avbrahm/PWR-MGR-PCB/README.md

# PWR-MGR-PCB
Power Management PCB with USB-C.
Designed to handle single cell lipo charging with direct power path. Outputs regulated 3.3V for microcontrollers and ESD protected USB data lines. 

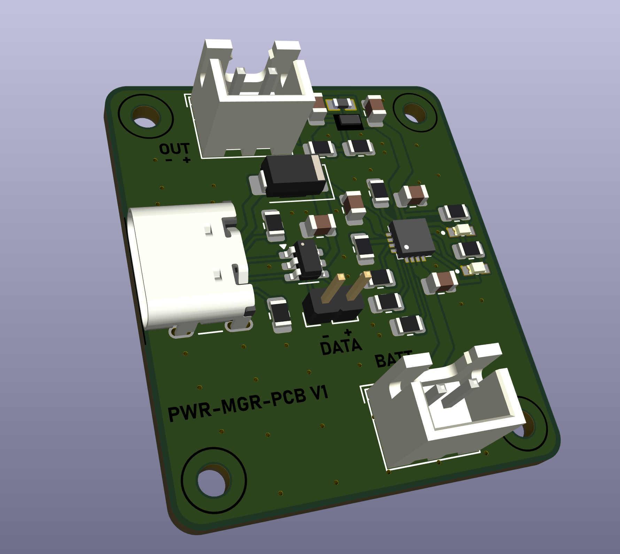
[picture p1: board.png]
Board
