avbrahm/PWR-MGR-PCB/(list of files, drawings)

Other design files:
PWR-MGR-PCB/freerouting.dsn
PWR-MGR-PCB/temp-freerouting.dsn
