avbrahm/PWR-MGR-PCB/PWR-MGR-PCB/PWR-MGR-PCB.kicad_pcb

## KiCad design PWR-MGR-PCB/PWR-MGR-PCB.kicad_pcb (2026-10-29)

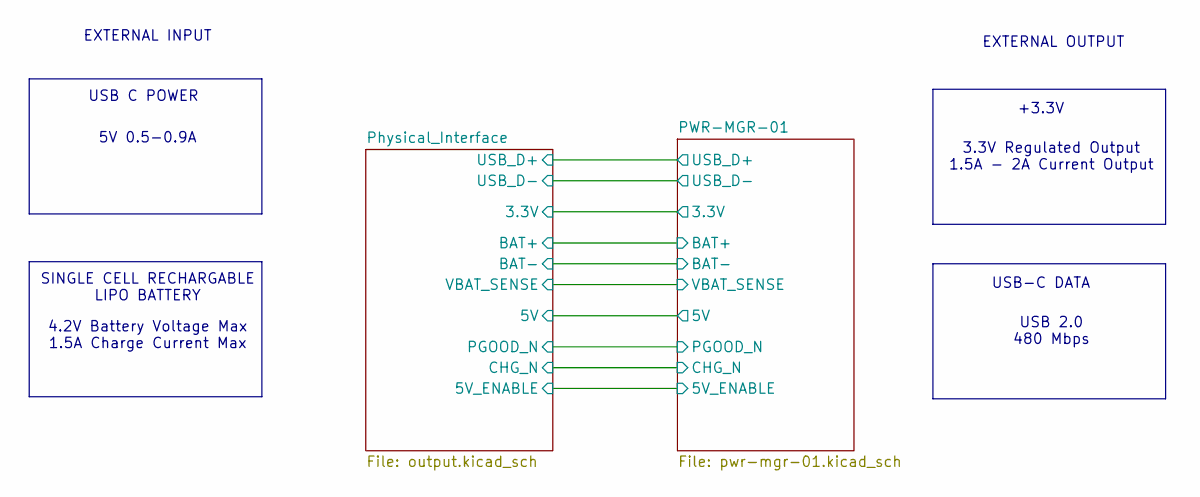
[picture p2: schematic PWR-MGR-PCB.kicad_sch, PWR-MGR-PCB-01]

Notes on the sheet:
SINGLE CELL RECHARGABLE LIPO BATTERY
USB 2.0 480 Mbps
3.3V Regulated Output 1.5A - 2A Current Output
5V 0.5-0.9A
EXTERNAL INPUT
4.2V Battery Voltage Max 1.5A Charge Current Max
USB-C DATA
EXTERNAL OUTPUT
USB C POWER
+3.3V

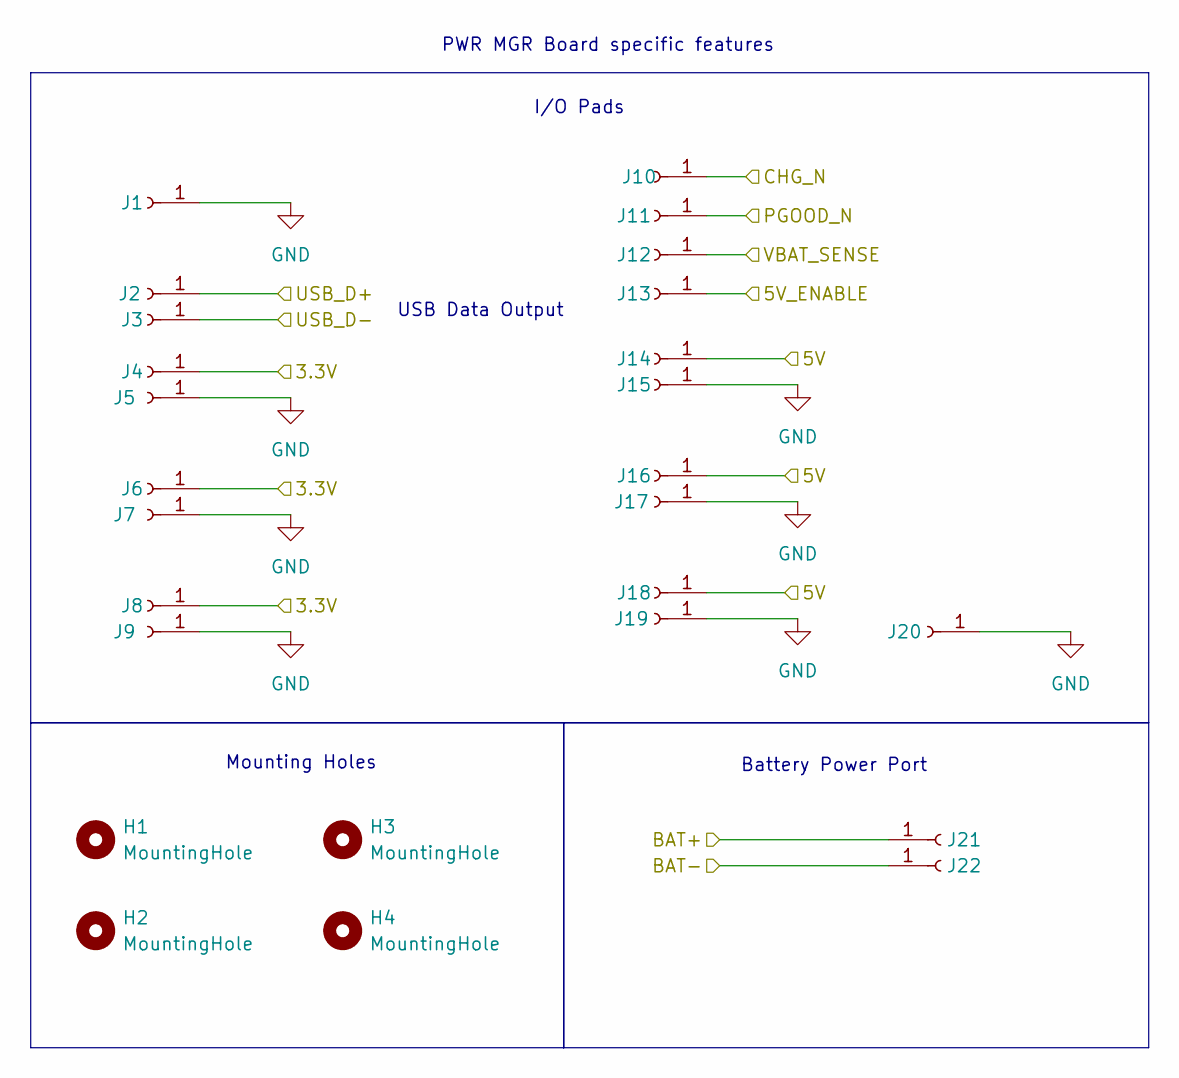
[picture p3: schematic output.kicad_sch]

Parts:
H1, H2, H3, H4: MountingHole; MountingHole_2.1mm
J1, J2, J3, J4, J5, J6, J7, J8, J9, J10, J11, J12, J13, J14, J15, J16, J17, J18, J19, J20, J21, J22: Conn_01x01_Socket; Drilled_Solder_Pad_0.6mm_3x1mm

Connections:
+3.3V: J4.1 (Pin_1_1), J6.1 (Pin_1_1), J8.1 (Pin_1_1); also elsewhere on the board
+5V: J14.1 (Pin_1_1), J16.1 (Pin_1_1), J18.1 (Pin_1_1); also elsewhere on the board
/PWR-MGR-01/5V_ENABLE: J13.1 (Pin_1_1); also elsewhere on the board
/PWR-MGR-01/BAT+: J21.1 (Pin_1_1); also elsewhere on the board
/PWR-MGR-01/CHG_N: J10.1 (Pin_1_1); also elsewhere on the board
/PWR-MGR-01/PGOOD_N: J11.1 (Pin_1_1); also elsewhere on the board
/PWR-MGR-01/USB_D+: J2.1 (Pin_1_1); also elsewhere on the board
/PWR-MGR-01/USB_D-: J3.1 (Pin_1_1); also elsewhere on the board
/PWR-MGR-01/VBAT_SENSE: J12.1 (Pin_1_1); also elsewhere on the board
GND: J1.1 (Pin_1_1), J5.1 (Pin_1_1), J7.1 (Pin_1_1), J9.1 (Pin_1_1), J15.1 (Pin_1_1), J17.1 (Pin_1_1), J19.1 (Pin_1_1), J20.1 (Pin_1_1), J22.1 (Pin_1_1); also elsewhere on the board

Notes on the sheet:
I/O Pads
Mounting Holes
Battery Power Port
PWR MGR Board specific features
USB Data Output

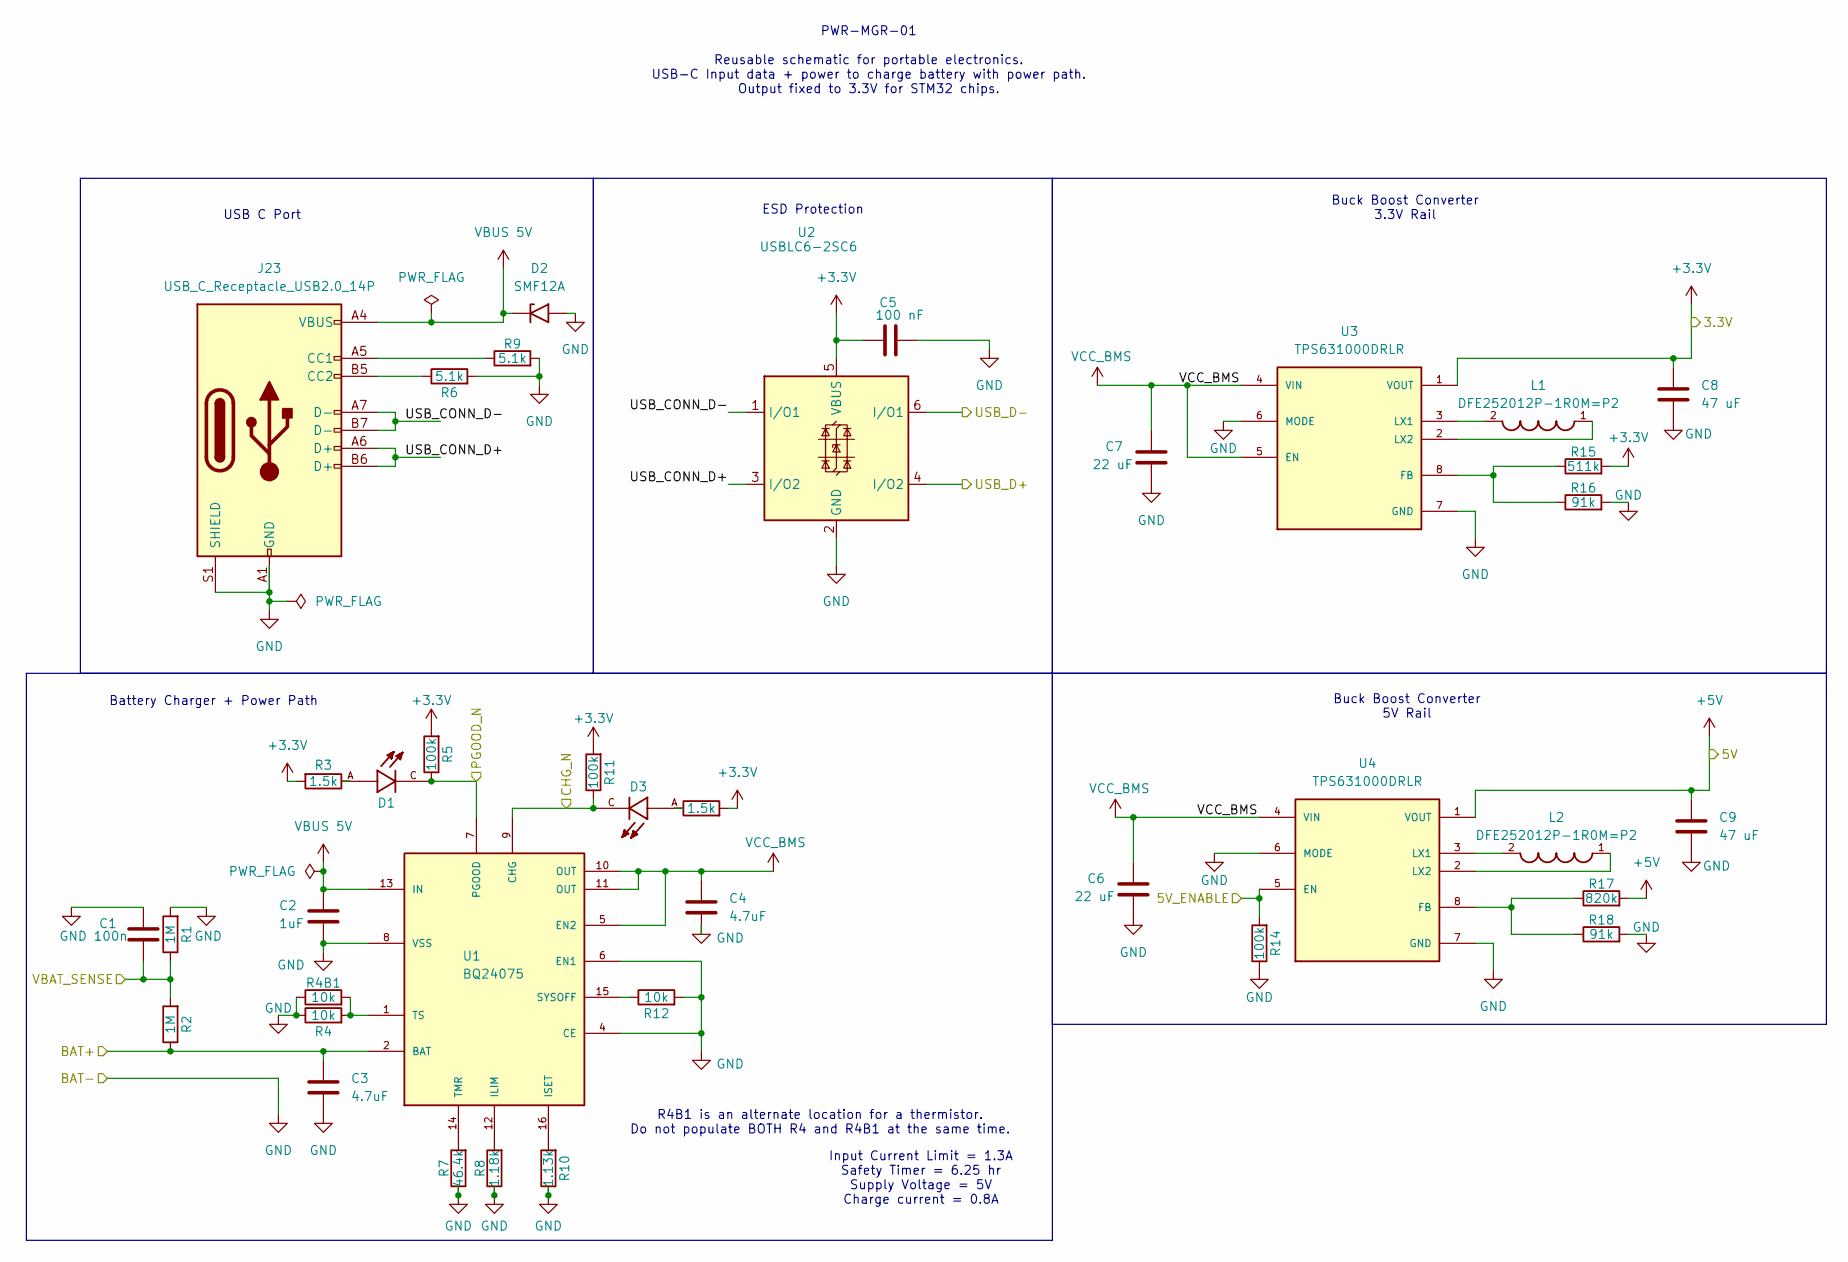
[picture p4: schematic pwr-mgr-01.kicad_sch]

Parts:
C1: 100n; C_0805_2012Metric; Manufacturer Part Number KAF21KR71H105JU
C2: 1uF; C_0805_2012Metric; Manufacturer Part Number KAF21KR71H105JU
C3, C4: 4.7uF; C_0805_2012Metric; Manufacturer Part Number CL21B475KBB6PNE
C5: 100 nF; C_0805_2012Metric; Manufacturer Part Number 08056D107MAT2A
C6, C7: 22 uF; C_0805_2012Metric; Manufacturer Part Number KAM21AT70J226MU
C8, C9: 47 uF; C_0805_2012Metric; Manufacturer Part Number CC0805MKX5R6BB476
D1, D3: SML-D12U1WT86; LED_SML-D12U1WT86; PARTREV 007
D2: SMF12A; D_SMF
J23: USB_C_Receptacle_USB2.0_14P; USB_C_Receptacle_GCT_USB4105-xx-A_16P_TopMnt_Horizontal; Manufacturer Part Number USB4105-GF-A
L1, L2: DFE252012P-1R0M=P2; INDC2520X120N
R1, R2: 1M; R_0805_2012Metric; Manufacturer Part Number MCU0805MD1002BP500
R3, R13: 1.5k; R_0805_2012Metric; Manufacturer Part Number RT73F2A1K5BTD
R4, R4B1: 10k; R_0805_2012Metric_Pad1.20x1.40mm_HandSolder; Manufacturer Part Number MCU0805MD1002BP500
R5, R11, R14: 100k; R_0805_2012Metric; Manufacturer Part Number MCU0805MD1002BP500
R6, R9: 5.1k; R_0805_2012Metric; Manufacturer Part Number ERA-6ARB512V
R7: 46.4k; R_0805_2012Metric; Manufacturer Part Number ERA-6AED4642V
R8: 1.18k; R_0805_2012Metric; Manufacturer Part Number ERJ-U06D1181V
R10: 1.13k; R_0805_2012Metric; Manufacturer Part Number PAT0805E1131BST1
R12: 10k; R_0805_2012Metric; Manufacturer Part Number MCU0805MD1002BP500
R15: 511k; R_0805_2012Metric; Manufacturer Part Number CR0805-FX-5113ELF
R16, R18: 91k; R_0805_2012Metric; Manufacturer Part Number ERA-6ARB913V
R17: 820k; R_0805_2012Metric; Manufacturer Part Number CR0805-FX-5113ELF
U1: BQ24075; QFN16; Manufacturer Part Number BQ24075RGTR
U2: USBLC6-2SC6; SOT-23-6; Manufacturer Part Number USBLC6-2SC6
U3, U4: TPS631000DRLR; SOT50P160X60-8N; PARTREV B

Connections:
+3.3V: C5.1, C8.1, R3.2, R5.2, R11.2, R13.2, R15.2, U2.5 (VBUS), U3.1 (VOUT); also elsewhere on the board
+5V: C9.1, R17.2, U4.1 (VOUT); also elsewhere on the board
/PWR-MGR-01/5V_ENABLE: R14.2, U4.5 (EN); also elsewhere on the board
/PWR-MGR-01/BAT+: C3.1, R2.1, U1.2 (BAT), U1.3 (BAT); also elsewhere on the board
/PWR-MGR-01/CHG_N: D3.C, R11.1, U1.9 (CHG); also elsewhere on the board
/PWR-MGR-01/PGOOD_N: D1.C, R5.1, U1.7 (PGOOD); also elsewhere on the board
/PWR-MGR-01/USB_CONN_D+: J23.A6 (D+), J23.B6 (D+), U2.3 (I/O2)
/PWR-MGR-01/USB_CONN_D-: J23.A7 (D-), J23.B7 (D-), U2.1 (I/O1)
/PWR-MGR-01/USB_D+: U2.4 (I/O2); also elsewhere on the board
/PWR-MGR-01/USB_D-: U2.6 (I/O1); also elsewhere on the board
/PWR-MGR-01/VBAT_SENSE: C1.2, R1.1, R2.2; also elsewhere on the board
GND: C1.1, C2.2, C3.2, C4.2, C5.2, C6.2, C7.2, C8.2, C9.2, D2.2 (A2), J23.A1 (GND), J23.A12 (GND), J23.B1 (GND), J23.B12 (GND), J23.S1 (SHIELD), R1.2, R4.1, R4B1.1, R6.2, R7.1, R8.1, R9.2, R10.1, R12.2, R14.1, R16.2, R18.2, U1.4 (CE), U1.6 (EN1), U1.8 (VSS), U1.TH (VSS), U2.2 (GND), U3.6 (MODE), U3.7 (GND), U4.6 (MODE), U4.7 (GND); also elsewhere on the board
unnamed: D1.A, R3.1
unnamed: D3.A, R13.1
unnamed: J23.A5 (CC1), R9.1
unnamed: J23.B5 (CC2), R6.1
unnamed: R8.2, U1.12 (ILIM)
unnamed: R10.2, U1.16 (ISET)
unnamed: R12.1, U1.15 (SYSOFF)
unnamed: R7.2, U1.14 (TMR)
unnamed: R4.2, R4B1.2, U1.1 (TS)
unnamed: R15.1, R16.1, U3.8 (FB)
unnamed: L1.2, U3.3 (LX1)
unnamed: L1.1, U3.2 (LX2)
unnamed: R17.1, R18.1, U4.8 (FB)
unnamed: L2.2, U4.3 (LX1)
unnamed: L2.1, U4.2 (LX2)
VBUS 5V: C2.1, D2.1 (A1), J23.A4 (VBUS), J23.A9 (VBUS), J23.B4 (VBUS), J23.B9 (VBUS), U1.13 (IN)
VCC_BMS: C4.1, C6.1, C7.1, U1.5 (EN2), U1.10 (OUT), U1.11 (OUT), U3.4 (VIN), U3.5 (EN), U4.4 (VIN)

Notes on the sheet:
Input Current Limit = 1.3A Safety Timer = 6.25 hr Supply Voltage = 5V Charge current = 0.8A
Battery Charger + Power Path
Buck Boost Converter 3.3V Rail
R4B1 is an alternate location for a thermistor. Do not populate BOTH R4 and R4B1 at the same time.
Buck Boost Converter 5V Rail
USB C Port
ESD Protection
PWR-MGR-01 Reusable schematic for portable electronics. USB-C Input data + power to charge battery with power path. Output fixed to 3.3V for STM32 chips.

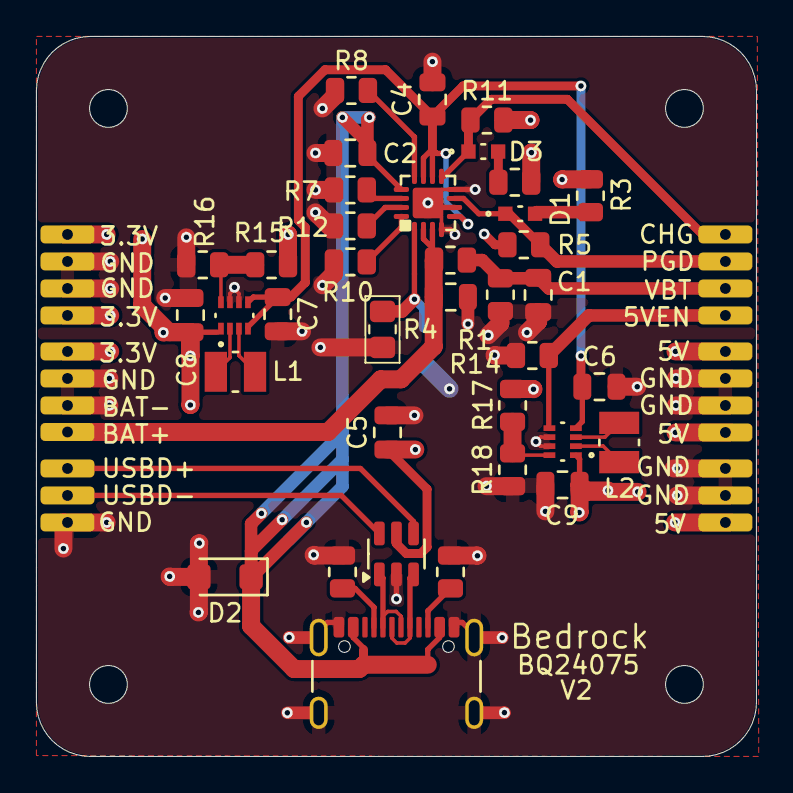
[picture p5: board PWR-MGR-PCB.kicad_pcb from above]

Board: 4 copper layers, 40.0 x 40.0 mm, 64 parts (1 on the bottom side), 29 nets.
