avbrahm/PWR-MGR-PCB/(commit log)

2025-09-09 Init Repo
    [PWR-MGR-PCB.kicad_pcb, PWR-MGR-PCB.kicad_sch]
2025-09-10 Add test ports
    [PWR-MGR-PCB.kicad_pcb, PWR-MGR-PCB.kicad_sch]
2025-09-10 Start layout
    [PWR-MGR-PCB.kicad_pcb]
2025-09-14 Layout PCB
    [PWR-MGR-PCB.kicad_pcb]
2025-09-14 Resize board
    [PWR-MGR-PCB.kicad_pcb]
2025-09-14 Fix board layout
    [freerouting.dsn]
2025-09-18 Layout board
    [PWR-MGR-PCB.kicad_pcb]
2025-09-19 Route board
    [PWR-MGR-PCB.kicad_pcb, freerouting.dsn]
2025-09-24 Reroute board
    [PWR-MGR-PCB.kicad_pcb, PWR-MGR-PCB.kicad_sch]
2025-09-30 Sync latest fixes
    [PWR-MGR-PCB.kicad_sch]
2025-09-30 Update diode component
    [PWR-MGR-PCB.kicad_pcb, PWR-MGR-PCB.kicad_sch]
2025-10-07 Begin placing board
    [PWR-MGR-PCB.kicad_pcb]
2025-10-07 Refine outline
    [PWR-MGR-PCB.kicad_pcb]
2025-10-07 Start placement
    [PWR-MGR-PCB.kicad_pcb]
2025-10-14 Start bq2407 zones
    [PWR-MGR-PCB.kicad_pcb]
2025-10-16 Add filled zones around battery charger
    [PWR-MGR-PCB.kicad_pcb]
2025-10-16 Add power LEDs, connect battery terminal
    [PWR-MGR-PCB.kicad_pcb]
2025-10-18 Replace LDO with buck boost converter
    [PWR-MGR-PCB.kicad_sch]
2025-10-18 Add inductor
    [PWR-MGR-PCB.kicad_sch]
2025-10-18 Configure buck boost converter
    [PWR-MGR-PCB.kicad_pcb, PWR-MGR-PCB.kicad_sch]
2025-10-22 Route buck boost converter, add ground plane
    [PWR-MGR-PCB.kicad_pcb, PWR-MGR-PCB.kicad_sch]
2025-10-22 Add USB lines, add mount holes, add power port
    [PWR-MGR-PCB.kicad_pcb, PWR-MGR-PCB.kicad_sch]
2025-10-24 Format sheet for reusability
    [PWR-MGR-PCB.kicad_sch, output.kicad_sch, pwrmgr01.kicad_sch]
2025-10-24 Fix naming
    [PWR-MGR-PCB.kicad_sch, pwr-mgr-01.kicad_sch]
2025-11-09 Change USB-C to 6 pin
    [PWR-MGR-PCB.kicad_pcb, pwr-mgr-01.kicad_sch]
2025-11-13 Switch back to 16 pin
    [PWR-MGR-PCB.kicad_pcb, pwr-mgr-01.kicad_sch]
2025-11-14 Begin layout
    [PWR-MGR-PCB.kicad_pcb]
2025-11-19 New layout
    [PWR-MGR-PCB.kicad_pcb]
2025-11-20 Complete USB-C tracing
    [PWR-MGR-PCB.kicad_pcb]
2025-11-26 Improve USB routing
    [PWR-MGR-PCB.kicad_pcb, pwr-mgr-01.kicad_sch]
2025-11-26 Finish USB data routing, connect VBUS to BQ2407
    [PWR-MGR-PCB.kicad_pcb, output.kicad_sch]
2025-11-27 Optimize trace width for current
    [PWR-MGR-PCB.kicad_pcb]
2025-11-27 Connect VBATT
    [PWR-MGR-PCB.kicad_pcb]
2025-11-28 Layout buck boost converter
    [PWR-MGR-PCB.kicad_pcb]
2025-12-02 Change zone connection types, change connectors, add zones for buck boost converter
    [PWR-MGR-PCB.kicad_pcb, output.kicad_sch]
2025-12-02 Routing complete
    [PWR-MGR-PCB.kicad_pcb]
2025-12-04 DRC checks
    [PWR-MGR-PCB.kicad_pcb]
2025-12-05 Solve DRC
    [PWR-MGR-PCB.kicad_pcb]
2025-12-07 Add BQ24075
    [PWR-MGR-PCB.kicad_pcb, pwr-mgr-01.kicad_sch]
2025-12-10 Route BQ24075
    [PWR-MGR-PCB.kicad_pcb, pwr-mgr-01.kicad_sch]
2025-12-10 Fix SBU tracks
    [PWR-MGR-PCB.kicad_pcb]
2025-12-16 Solve all DRC issues
    [PWR-MGR-PCB.kicad_pcb]
2025-12-16 Solve all ERC issues
    [PWR-MGR-PCB.kicad_pcb, pwr-mgr-01.kicad_sch]
2025-12-18 Add MPNs and generate DRL file
    [PWR-MGR-PCB.kicad_pcb, output.kicad_sch, pwr-mgr-01.kicad_sch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]
2025-12-27 Adjust boost converter FB pin
    [PWR-MGR-PCB.kicad_pcb, pwr-mgr-01.kicad_sch]
2025-12-28 Pull down SYSOFF
    [pwr-mgr-01.kicad_sch]
2026-01-07 Shorten traces
    [PWR-MGR-PCB-B_Cu.gbl, PWR-MGR-PCB-B_Mask.gbs, PWR-MGR-PCB-B_Silkscreen.gbo, PWR-MGR-PCB-Edge_Cuts.gm1, PWR-MGR-PCB-F_Cu.gtl, PWR-MGR-PCB-F_Mask.gts, PWR-MGR-PCB-F_Silkscreen.gto, PWR-MGR-PCB-bottom-pos.csv]
2026-01-07 Improve capacitor position
    [PWR-MGR-PCB.kicad_pcb]
2026-01-11 Update layout, optimize sub-sheet for reusability
    [PWR-MGR-PCB.kicad_pcb, PWR-MGR-PCB.kicad_sch, output.kicad_sch]
2026-01-11 Fill in top plane, remove outdated files
    [PWR-MGR-PCB-B_Cu.gbl, PWR-MGR-PCB-B_Mask.gbs, PWR-MGR-PCB-B_Silkscreen.gbo, PWR-MGR-PCB-Edge_Cuts.gm1, PWR-MGR-PCB-F_Cu.gtl, PWR-MGR-PCB-F_Mask.gts, PWR-MGR-PCB-F_Silkscreen.gto, PWR-MGR-PCB-bottom-pos.csv]
2026-01-15 Update fabrication outputs
    [PWR-MGR-PCB-B_Cu.gbl, PWR-MGR-PCB-B_Mask.gbs, PWR-MGR-PCB-B_Paste.gbp, PWR-MGR-PCB-B_Silkscreen.gbo, PWR-MGR-PCB-Edge_Cuts.gm1, PWR-MGR-PCB-F_Cu.gtl, PWR-MGR-PCB-F_Mask.gts, PWR-MGR-PCB-F_Paste.gtp]
2026-01-16 Production ready!
    [PWR-MGR-PCB.kicad_pcb, pwr-mgr-01.kicad_sch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]
2026-01-20 Update imaeg
    [PWR-MGR-PCB.kicad_pcb]
2026-03-24 Update gitignore
    [PWR-MGR-PCB-B_Cu.gbl, PWR-MGR-PCB-B_Mask.gbs, PWR-MGR-PCB-B_Paste.gbp, PWR-MGR-PCB-B_Silkscreen.gbo, PWR-MGR-PCB-Edge_Cuts.gm1, PWR-MGR-PCB-F_Cu.gtl, PWR-MGR-PCB-F_Mask.gts, PWR-MGR-PCB-F_Paste.gtp]
2026-06-16 align ports
    [PWR-MGR-PCB.kicad_pcb, pwr-mgr-01.kicad_sch]
2026-07-02 fix placements + edit C3 size
    [PWR-MGR-PCB-B_Cu.gbl, PWR-MGR-PCB-B_Mask.gbs, PWR-MGR-PCB-B_Paste.gbp, PWR-MGR-PCB-B_Silkscreen.gbo, PWR-MGR-PCB-Edge_Cuts.gm1, PWR-MGR-PCB-F_Cu.gtl, PWR-MGR-PCB-F_Fab.gbr, PWR-MGR-PCB-F_Mask.gts]
2026-07-02 make better BOM
    [PWR-MGR-PCB_rev-BOM.csv, PWR-MGR-PCB_rev-BOM.ods]
2026-09-26 begin v2, update schematic
    [PWR-MGR-PCB-B_Cu.gbl, PWR-MGR-PCB-B_Mask.gbs, PWR-MGR-PCB-B_Paste.gbp, PWR-MGR-PCB-B_Silkscreen.gbo, PWR-MGR-PCB-Edge_Cuts.gm1, PWR-MGR-PCB-F_Cu.gtl, PWR-MGR-PCB-F_Fab.gbr, PWR-MGR-PCB-F_Mask.gts]
2026-09-26 complete schematic
    [PWR-MGR-PCB.kicad_pcb, PWR-MGR-PCB.kicad_sch, output.kicad_sch, pwr-mgr-01.kicad_sch]
2026-09-28 route regulators
    [PWR-MGR-PCB.kicad_pcb, output.kicad_sch]
2026-10-02 fix footprint issues, route regulators
    [PWR-MGR-PCB.kicad_pcb, pwr-mgr-01.kicad_sch]
2026-10-06 route signals
    [PWR-MGR-PCB.kicad_pcb, output.kicad_sch, pwr-mgr-01.kicad_sch]
2026-10-19 add an extra current carrying via
